BIULab-BUAA/UARC_Pilot/Model/README.md

The file "Finned_UniCore.STEP","Legged_UniCore.STEP","Winged_UniCore.STEP" are the model files of the robot with three different limbs.
All models are developed by SolidWorks2023
