BIULab-BUAA/UARC_Pilot/Model/Finned_UniCore.STEP

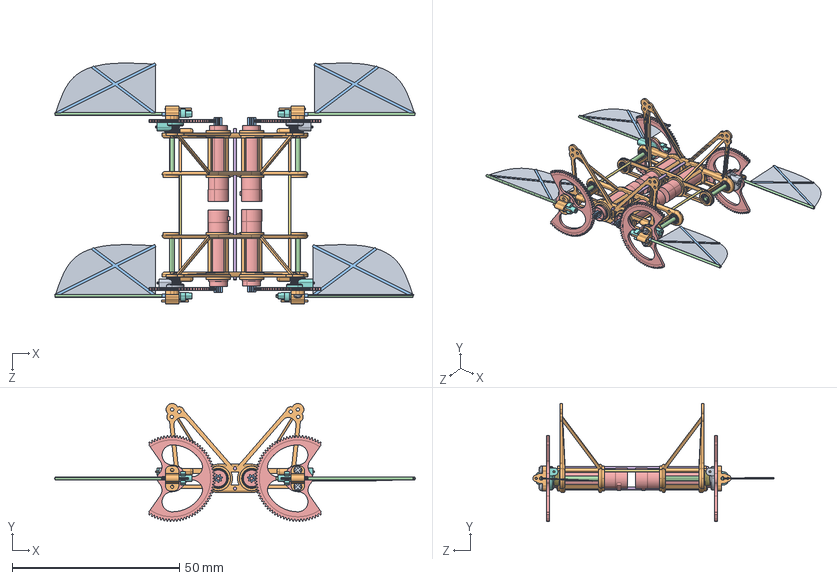
[picture p4: CAD file, 2024-12-29]
Model/Finned_UniCore.STEP
108.0 x 35.3 x 72.2 mm
finhalf_frame x 2
fin0.3M 7T x 4
fin1.5mm carbon shaft x 4
finECX6 x 4
findeep groove ball bearings gb_Rolling bearings 618-1.5 GB 276-94 x 8
finspringK137 x 2
finspring connector K137 x 2
finspring connector K137 (reversed) x 2
finspringK137 (clockwise) x 2
finwing root connector x 4
finwing root x 4
finwing bar 0.9mm x 4
fin84T gear_GB - Spur gear 0.3M 84T 20PA 1FW ---S84A75H50L1.5N x 4
fin1mm carbon connection x 2
fin0.8mm carbon connection x 2
finstopper 5deg x 4
screw-1mm x 2
0.6mm carbon x 4
fin x 4
fn-vein x 4
