BIULab-BUAA/UARC_Pilot/Model/Winged_UniCore.STEP

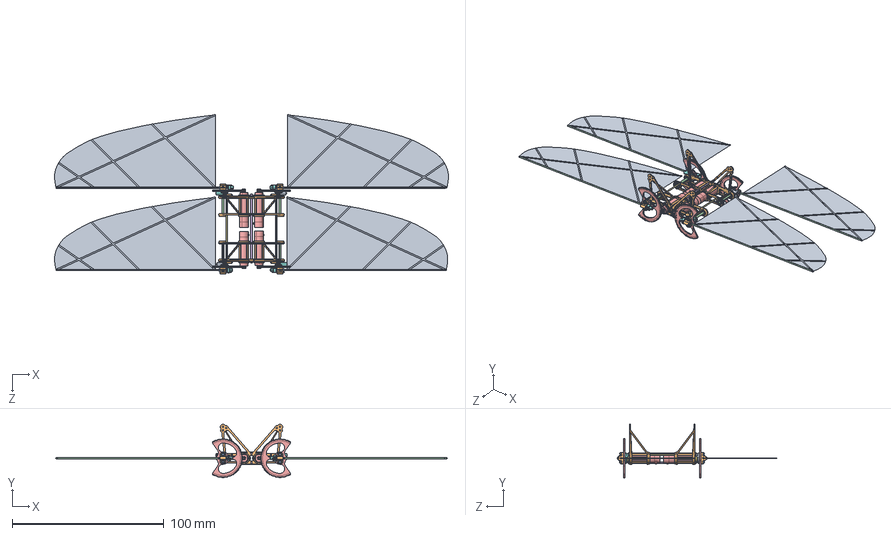
[picture p6: CAD file, 2024-12-29]
Model/Winged_UniCore.STEP
259.6 x 35.3 x 105.1 mm
wing_half_frame x 2
wing_0.3M 7T x 4
wing_1.5mm carbon shaft x 4
wing_ECX6 x 4
wing_deep groove ball bearings gb_Rolling bearings 618-1.5 GB 276-94 x 8
wing_springK137 x 2
wing_spring connector K137 x 2
wing_spring connector K137 (reversed) x 2
wing_springK137 (clockwise) x 2
wing_wing root connector x 4
wing_wing root x 4
wing_wing bar 0.9mm x 4
wing_84T gear_GB - Spur gear 0.3M 84T 20PA 1FW ---S84A75H50L1.5N x 4
wing_1mm carbon connection x 2
wing_0.8mm carbon connection x 2
wing_stopper 5deg x 4
wing_veins x 4
0.6mm carbon x 4
screw-1mm x 8
wing_surface x 4
